NiazHQ/pan-tilt-3d-scanner/cad/drawings/base_breakout_board_holder.png

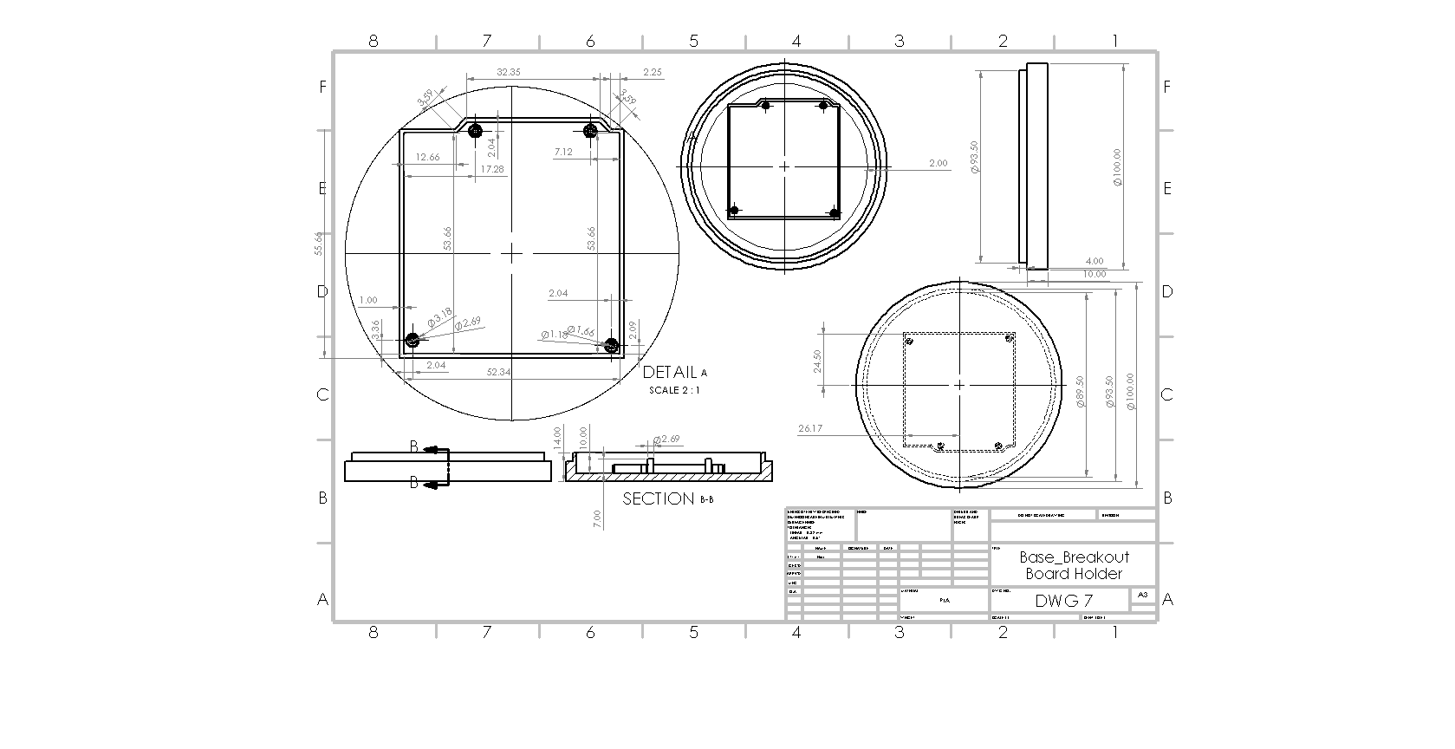
cad/drawings/base_breakout_board_holder.png
