NiazHQ/pan-tilt-3d-scanner/cad/drawings/base_cut.png

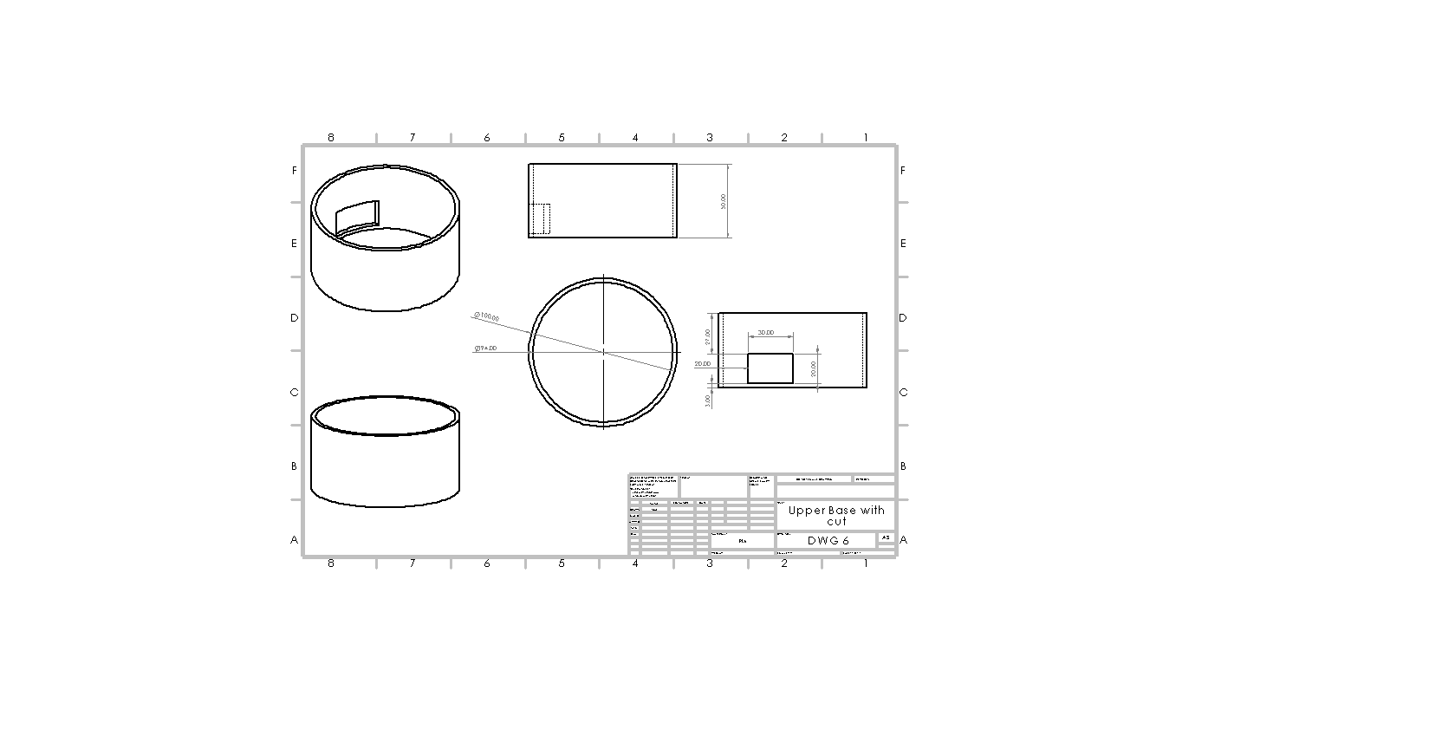
cad/drawings/base_cut.png
