NiazHQ/pan-tilt-3d-scanner/cad/drawings/pan_servo_plate.png

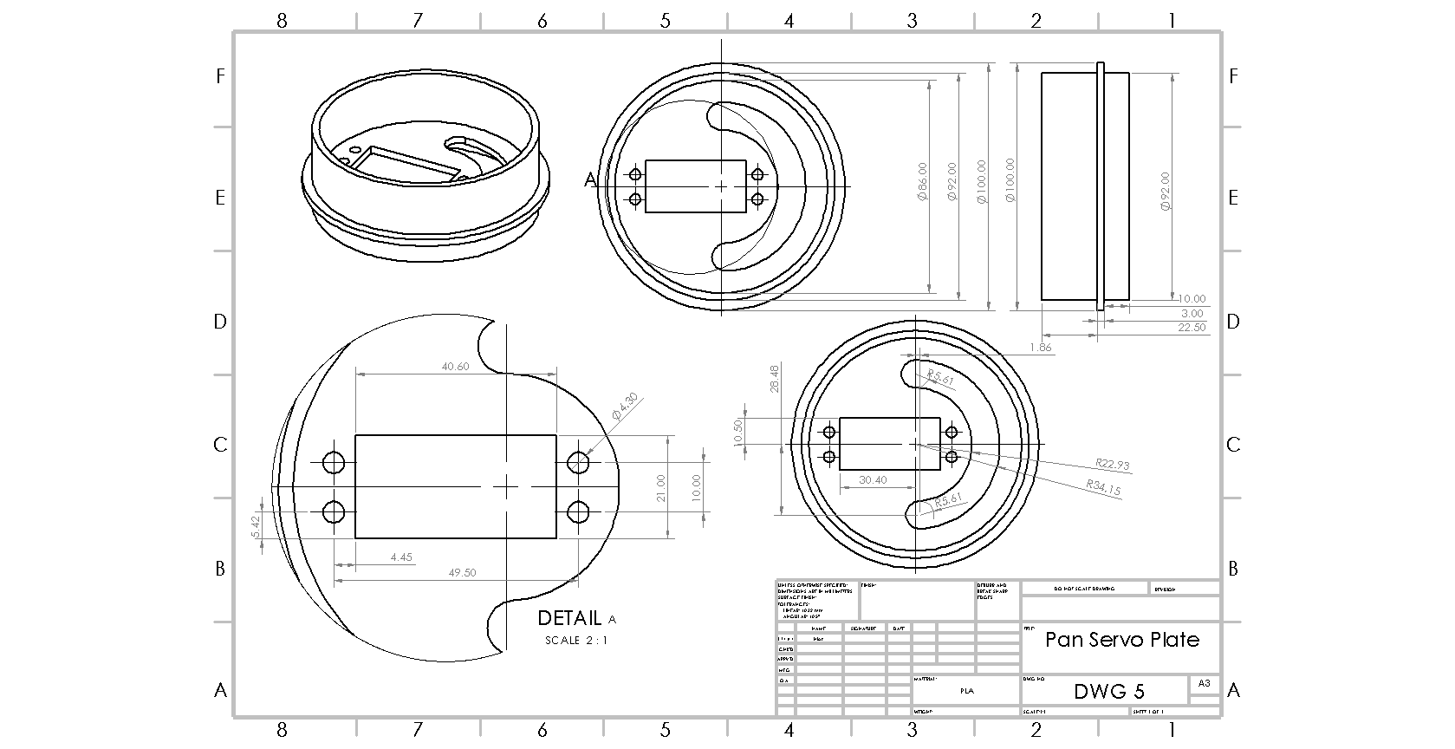
cad/drawings/pan_servo_plate.png
