NiazHQ/pan-tilt-3d-scanner/cad/drawings/sensor_holder.png

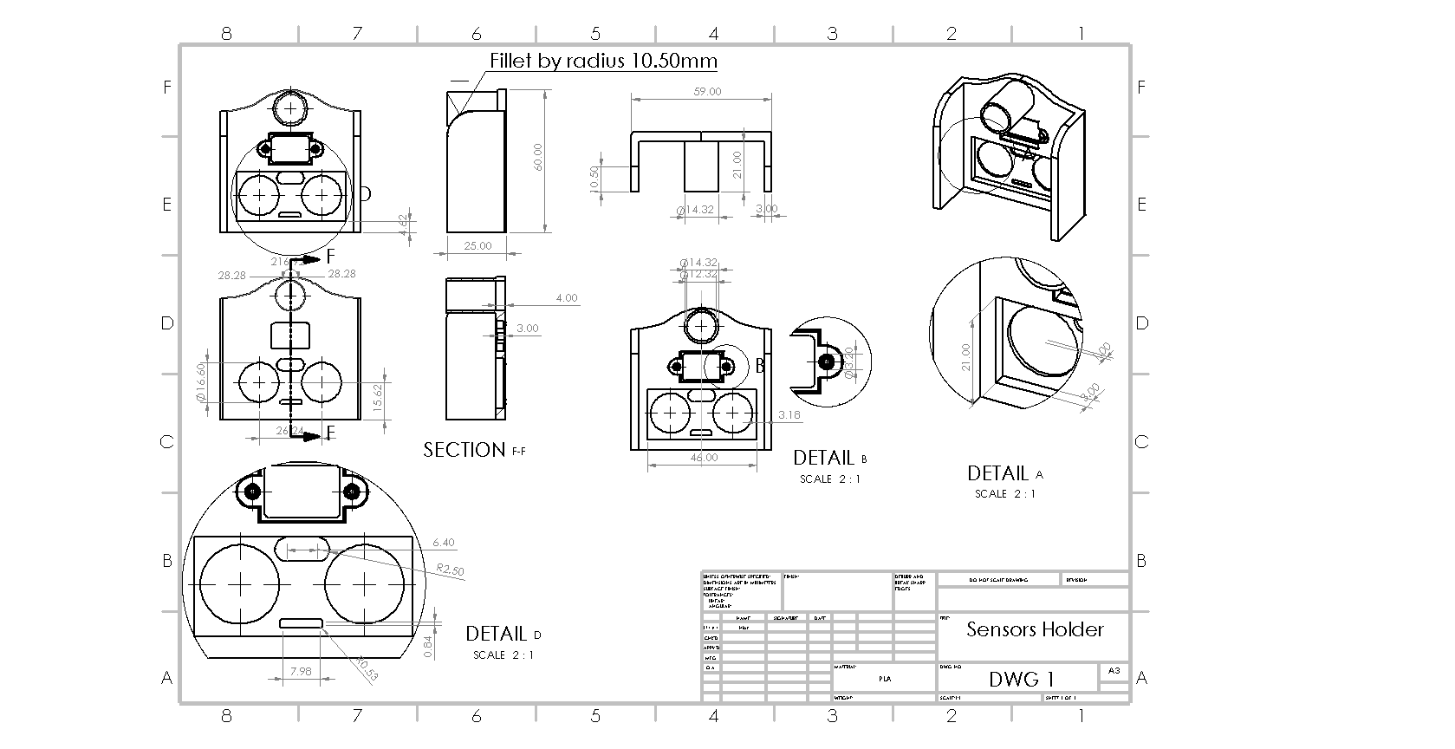
cad/drawings/sensor_holder.png
