NiazHQ/pan-tilt-3d-scanner/cad/drawings/servo_motor_mount.png

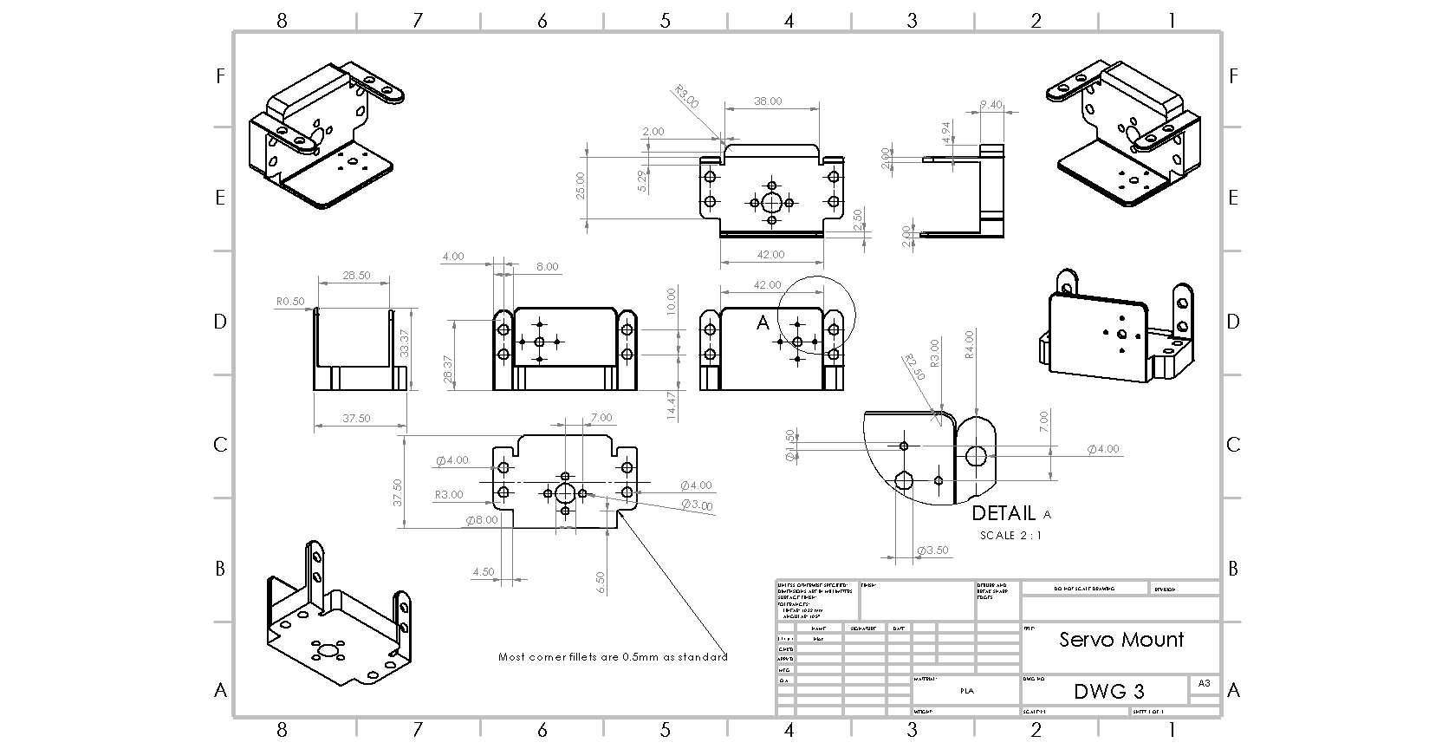
cad/drawings/servo_motor_mount.png
