NiazHQ/pan-tilt-3d-scanner/cad/drawings/servo_u-bracket.png

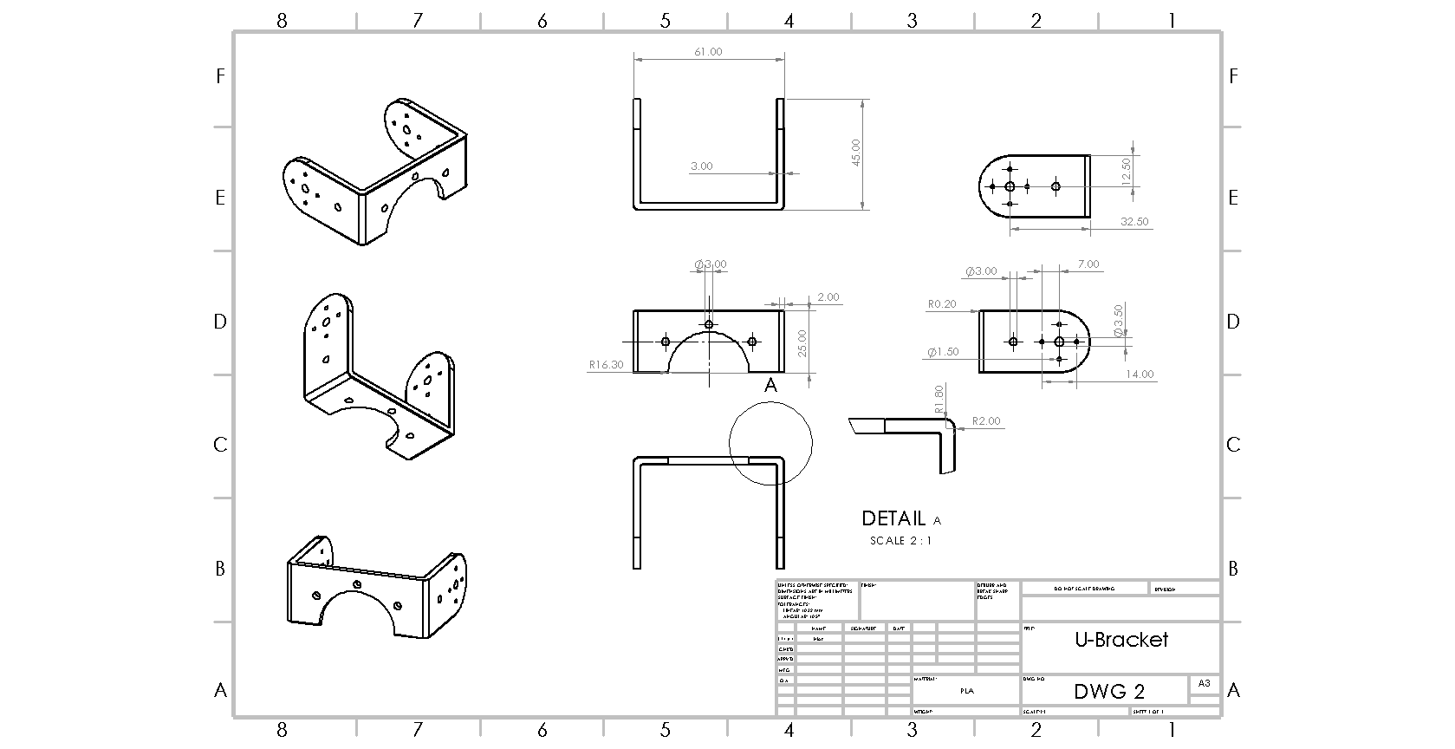
cad/drawings/servo_u-bracket.png
