NiazHQ/pan-tilt-3d-scanner/cad/drawings/tilt_servo_plate.png

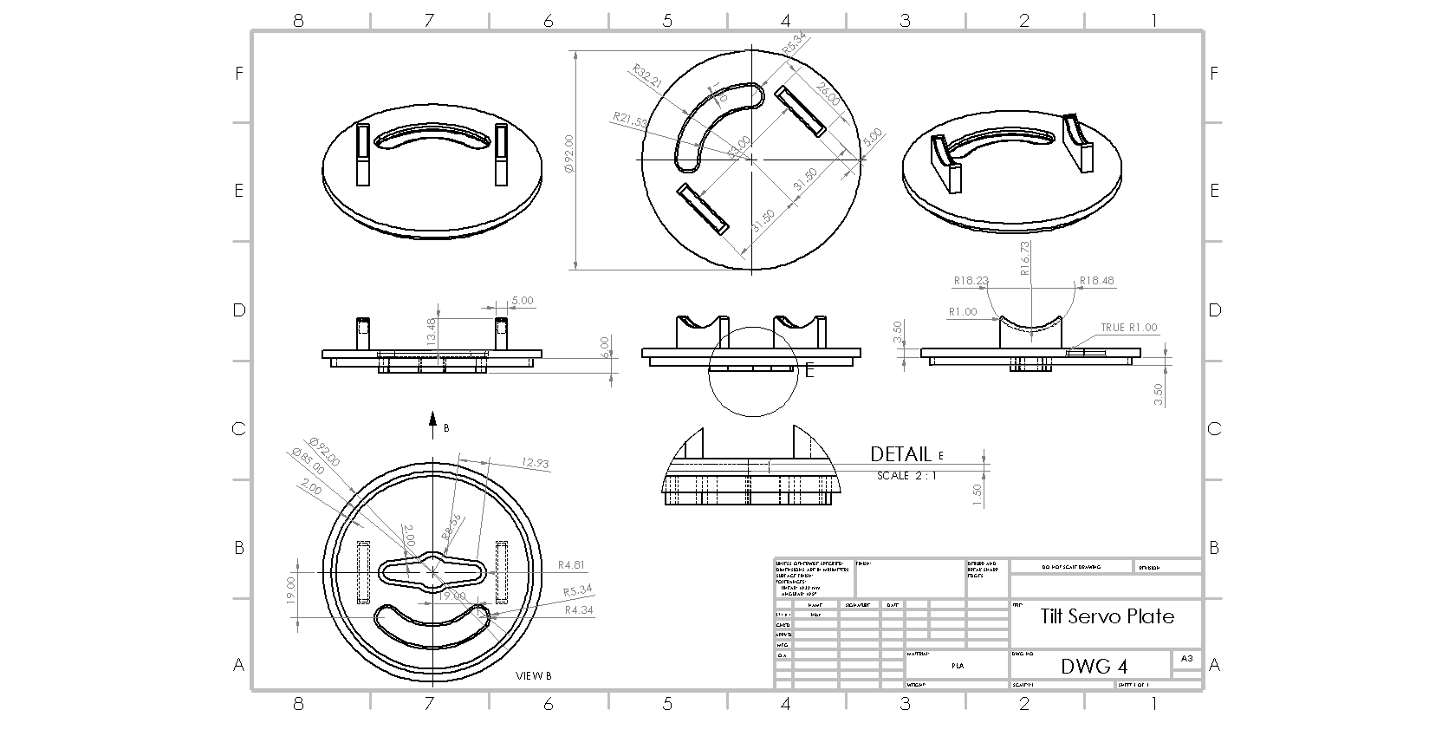
cad/drawings/tilt_servo_plate.png
