NiazHQ/pan-tilt-3d-scanner/docs/images/arduino_flow.png

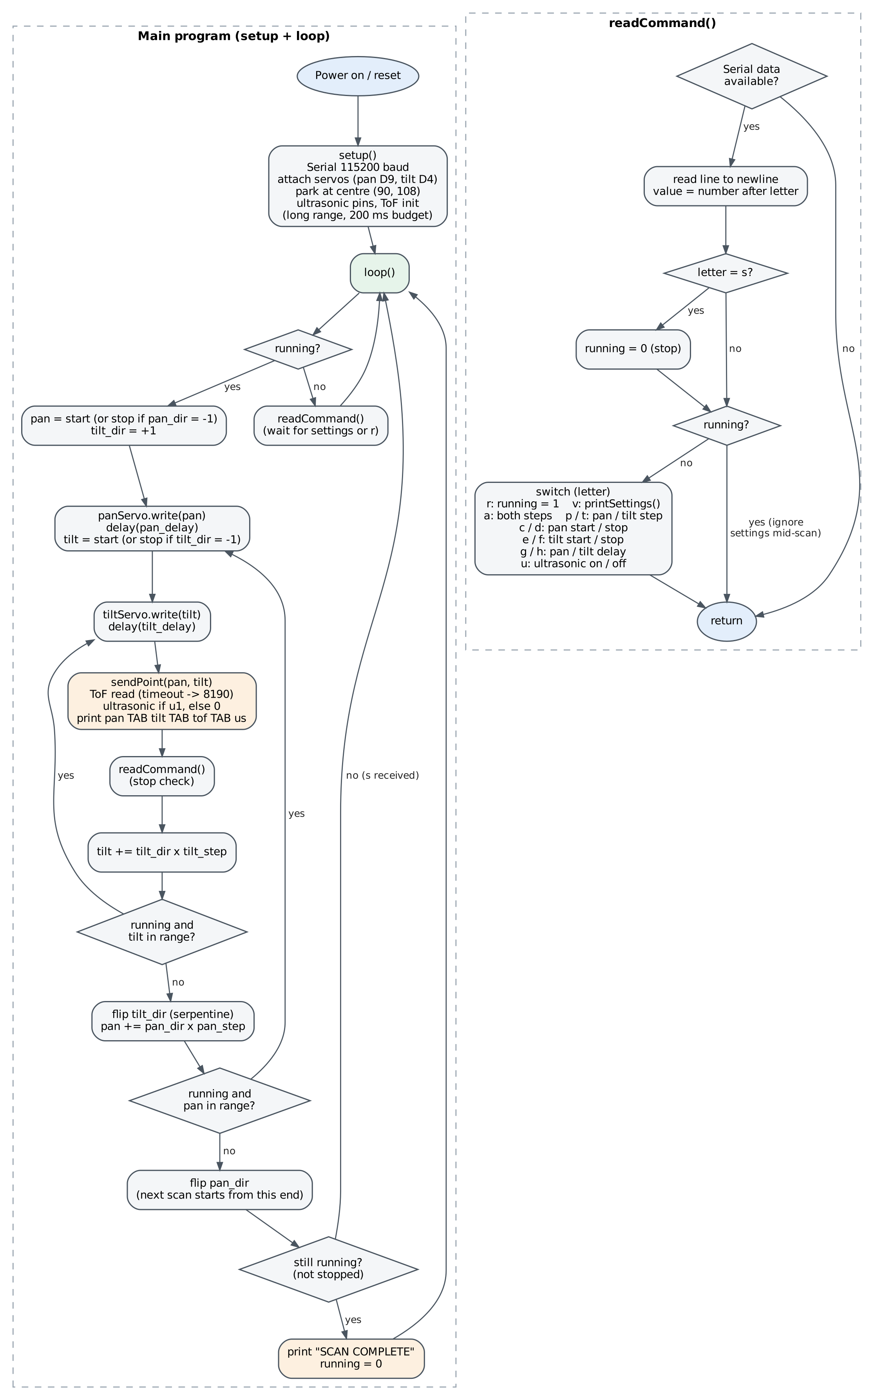
docs/images/arduino_flow.png
