NiazHQ/pan-tilt-3d-scanner/docs/images/gui_flow.png

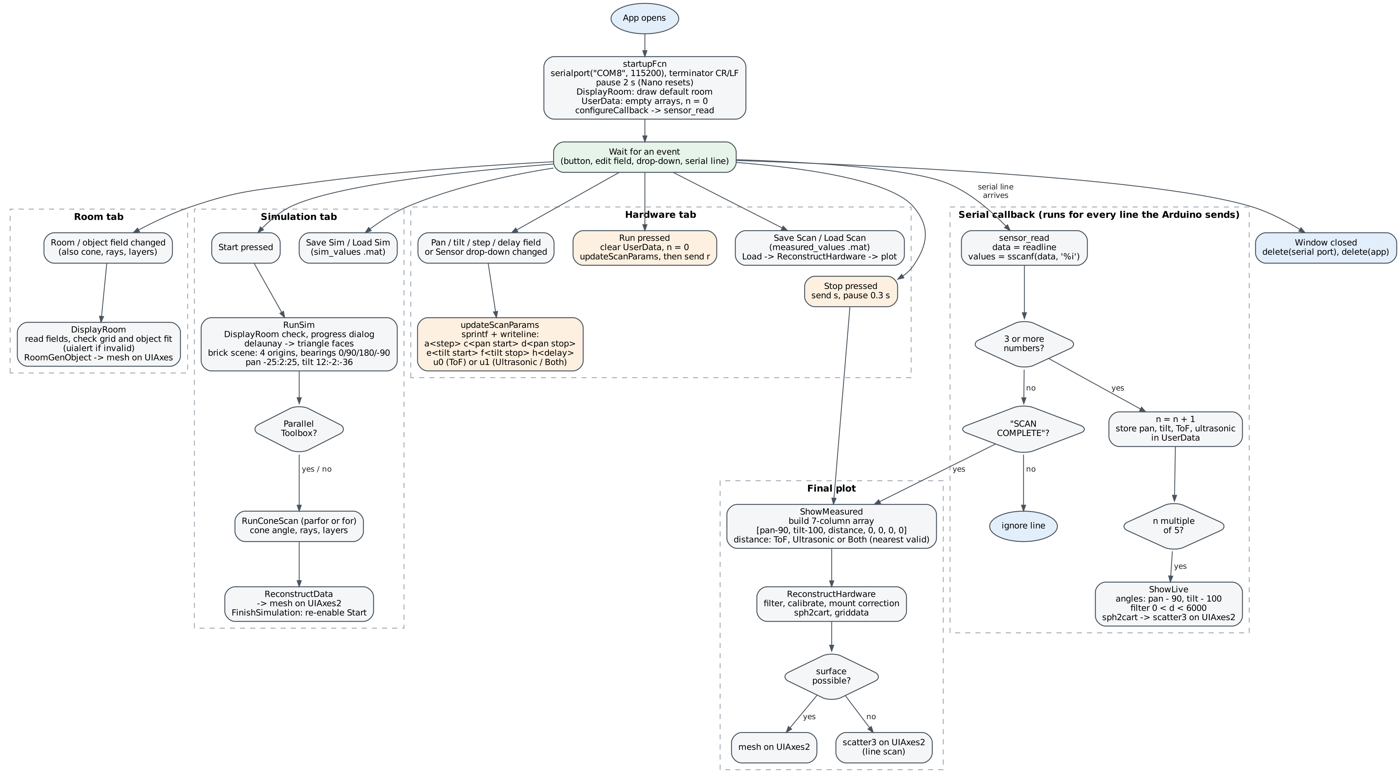
docs/images/gui_flow.png
