NiazHQ/pan-tilt-3d-scanner/docs/images/line_scan.png

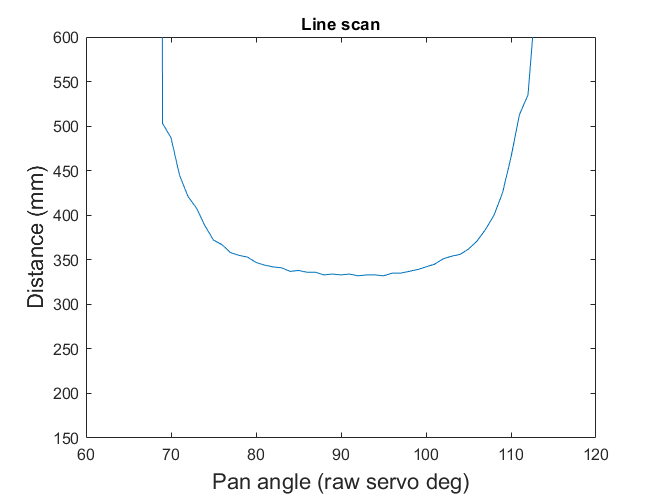
docs/images/line_scan.png
