NiazHQ/pan-tilt-3d-scanner/docs/images/photo_2.jpg

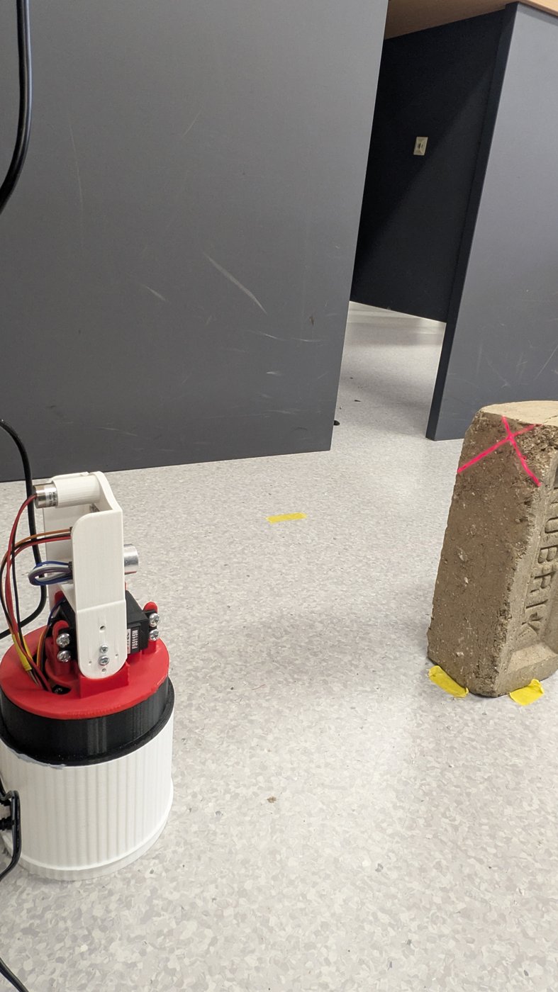
docs/images/photo_2.jpg
