NiazHQ/pan-tilt-3d-scanner/docs/images/photo_4.jpg

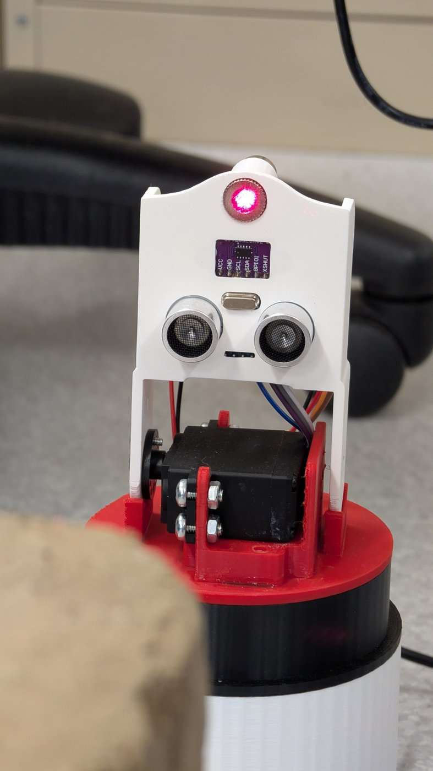
docs/images/photo_4.jpg
