NiazHQ/pan-tilt-3d-scanner/docs/images/repeatability.png

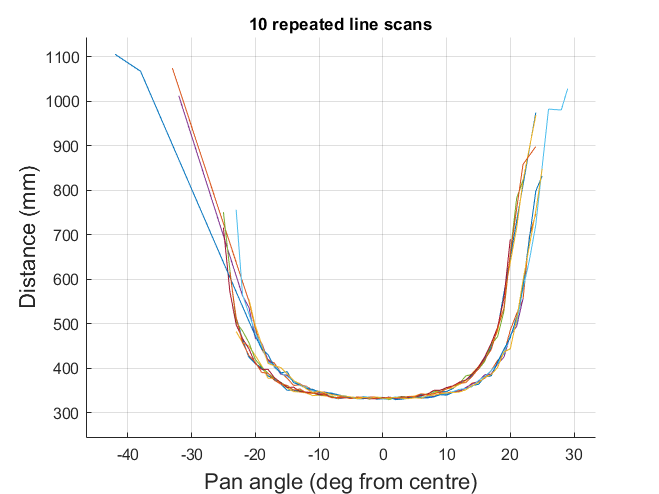
docs/images/repeatability.png
