NiazHQ/pan-tilt-3d-scanner/docs/images/single_origin_scan.png

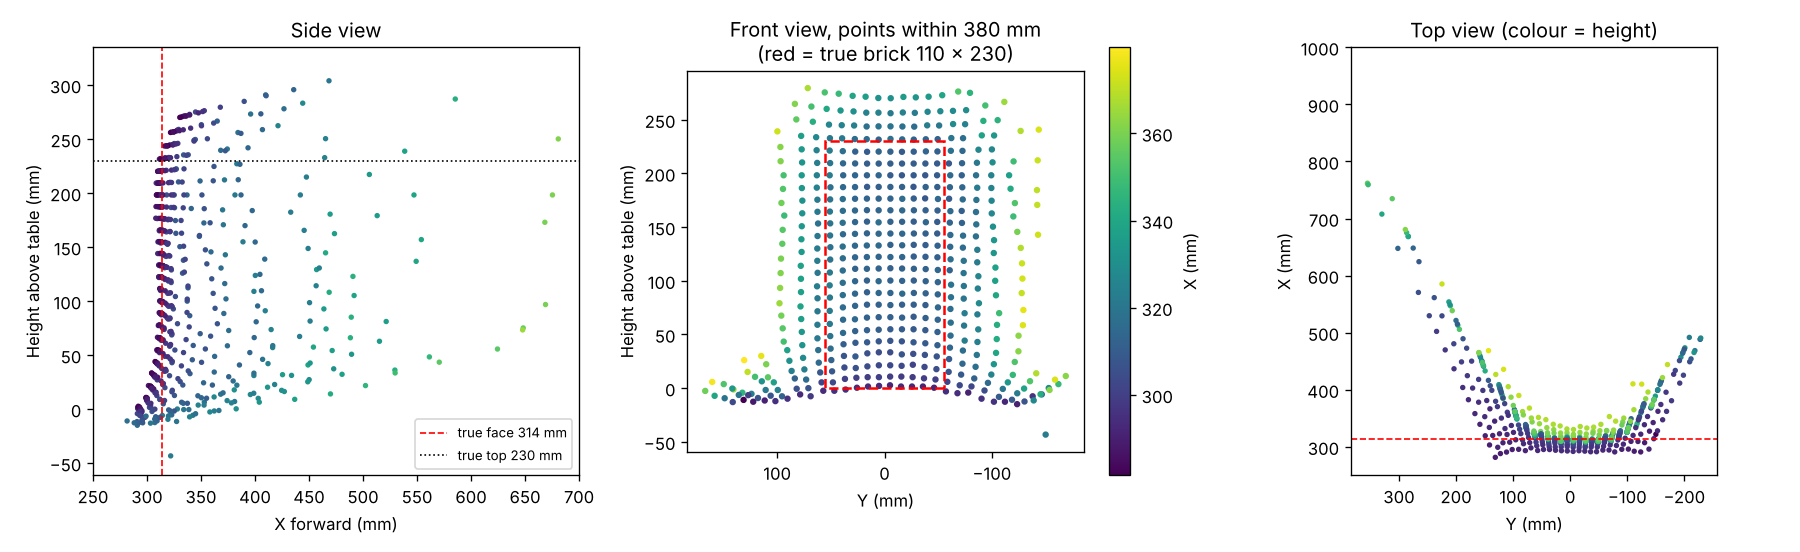
docs/images/single_origin_scan.png
