NiazHQ/pan-tilt-3d-scanner/docs/images/tof_vs_ultrasonic.png

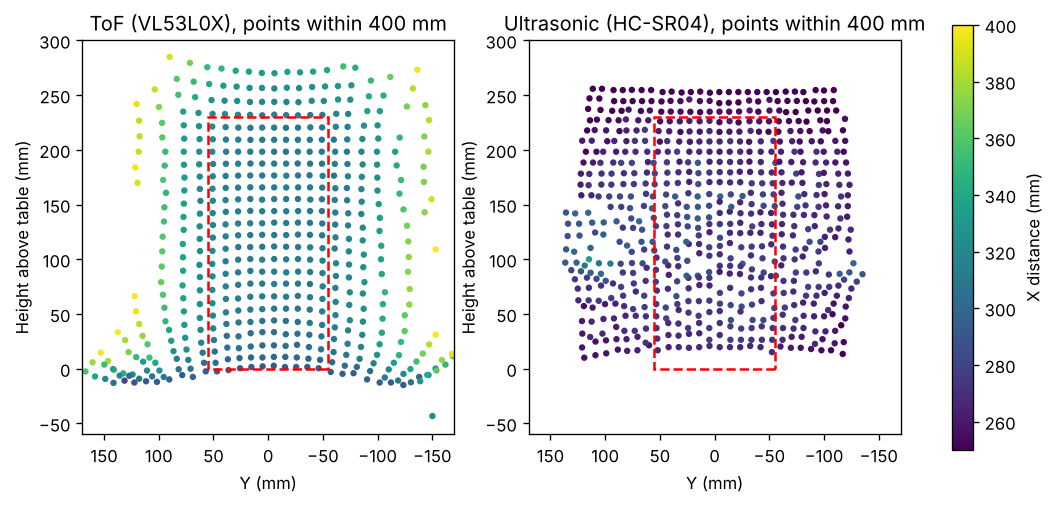
docs/images/tof_vs_ultrasonic.png
